enginarsun/remote-stm32-debug-gateway/docs/images/02-hardware-setup.png

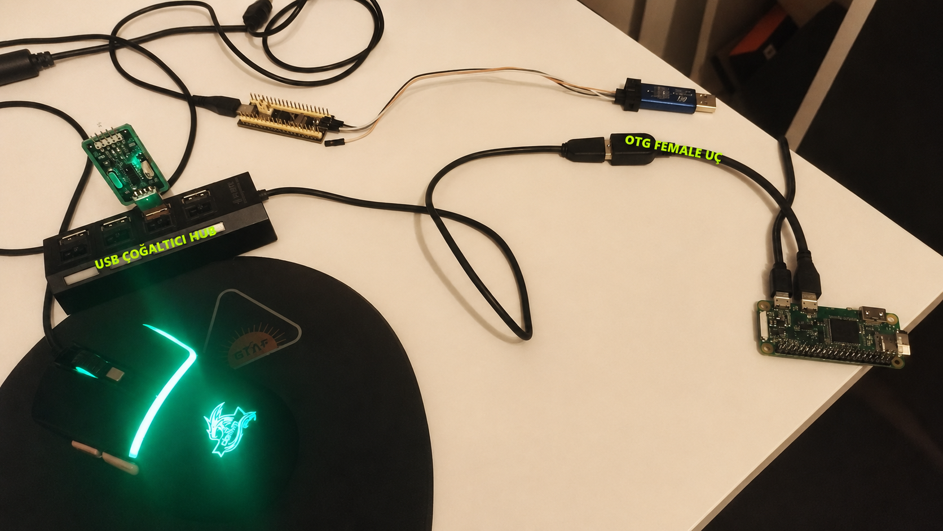
docs/images/02-hardware-setup.png
