enginarsun/remote-stm32-debug-gateway/(commit log)

2026-08-12 Add remote STM32 debug gateway: firmware, docs, and setup photos
2026-08-13 Add Flask web interface for flash and live UART log
2026-08-14 Add DHT11 sensor integration, fix UART line buffering, document ADC HardFault debugging
    [main.c]
2026-08-15 Test CI pipeline: adjust sensor read delay
2026-08-15 Test CI pipeline: revert delay
    [main.c]
